innovationcentralph/HeatIndex/Firmware/HeatIndex_ModbusRelay/ModbusRegisters.md

# Modbus Register Documentation

This file documents the Modbus registers used in the project. Each register has an address, type, default value, and a brief description.

## Register Table

| Address | Type  | Default Value | Description | Range | Unit | Data Type |
|---|---|---|---|---|---|---|
| 1 | COIL  | 0 | Relay 1 | | - | uint16_t |
| 2 | COIL  | 0 | Relay 2 | | - | uint16_t |
| 3 | COIL  | 0 | Relay 3 | | - | uint16_t |
| 4 | COIL  | 0 | Relay 4 | | - | uint16_t |
