innovationcentralph/HeatIndex/HeatIndex/1_2350513_2/c-1-2350513-2-1-3d.stp

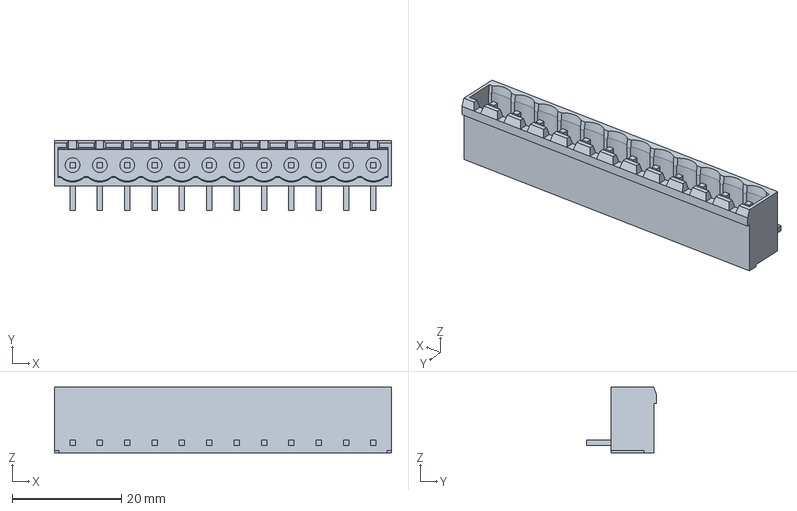
[picture p3: CAD file, 2025-08-19]
HeatIndex/1_2350513_2/c-1-2350513-2-1-3d.stp
61.6 x 12.8 x 12.0 mm
