innovationcentralph/HeatIndex/HeatIndex/APC_817B1_SL/APC-817xx-SL_AMB.step

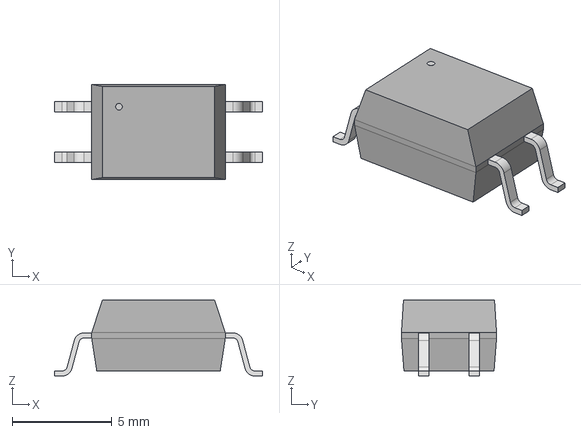
[picture p4: CAD file, 2025-08-19]
HeatIndex/APC_817B1_SL/APC-817xx-SL_AMB.step
10.4 x 4.78 x 3.81 mm
