innovationcentralph/HeatIndex/HeatIndex/B0505S_2WR3/B_S-2WR2_MNS.step

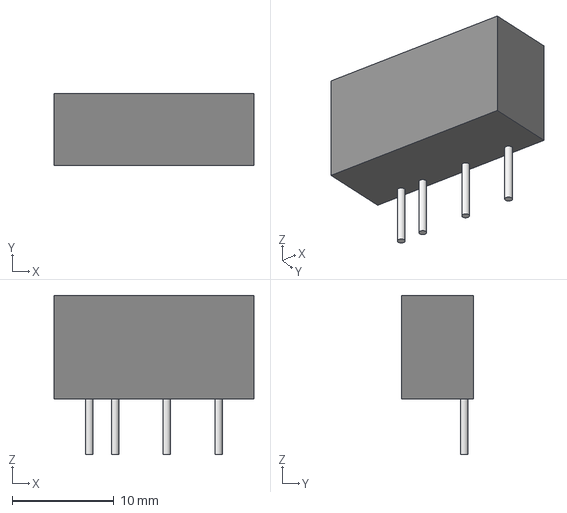
[picture p5: CAD file, 2025-08-19]
HeatIndex/B0505S_2WR3/B_S-2WR2_MNS.step
19.7 x 7.06 x 15.6 mm
