innovationcentralph/HeatIndex/HeatIndex/PC817X2NIP1B_SHP.step

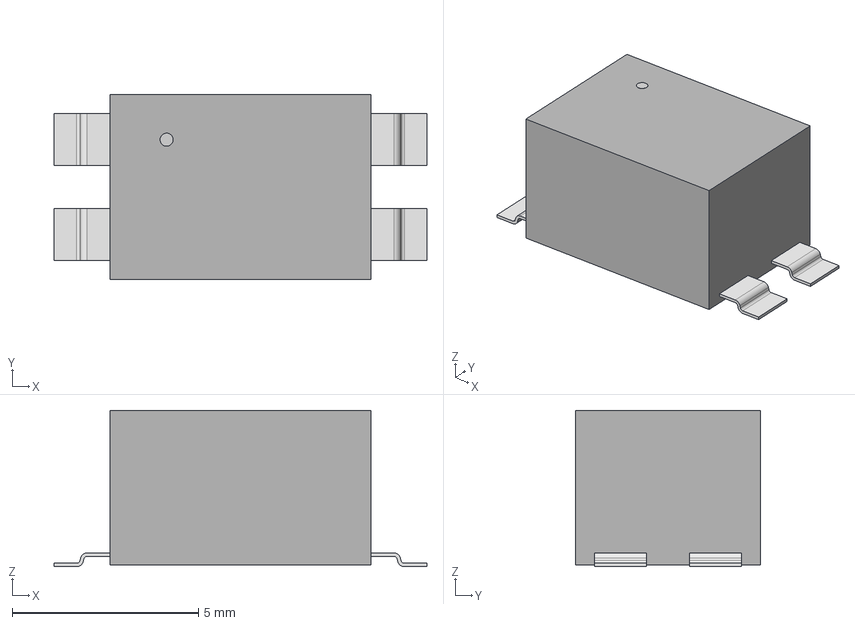
[picture p6: CAD file, 2025-08-19]
HeatIndex/PC817X2NIP1B_SHP.step
10.0 x 4.95 x 4.19 mm
