innovationcentralph/HeatIndex/(list of files, cad)

Other CAD files:
HeatIndex/B_S-2WR2_MNS.step
