innovationcentralph/HeatIndex/HeatIndex/HeatIndex.kicad_pcb

## KiCad design HeatIndex/HeatIndex.kicad_pcb (2025-09-29)

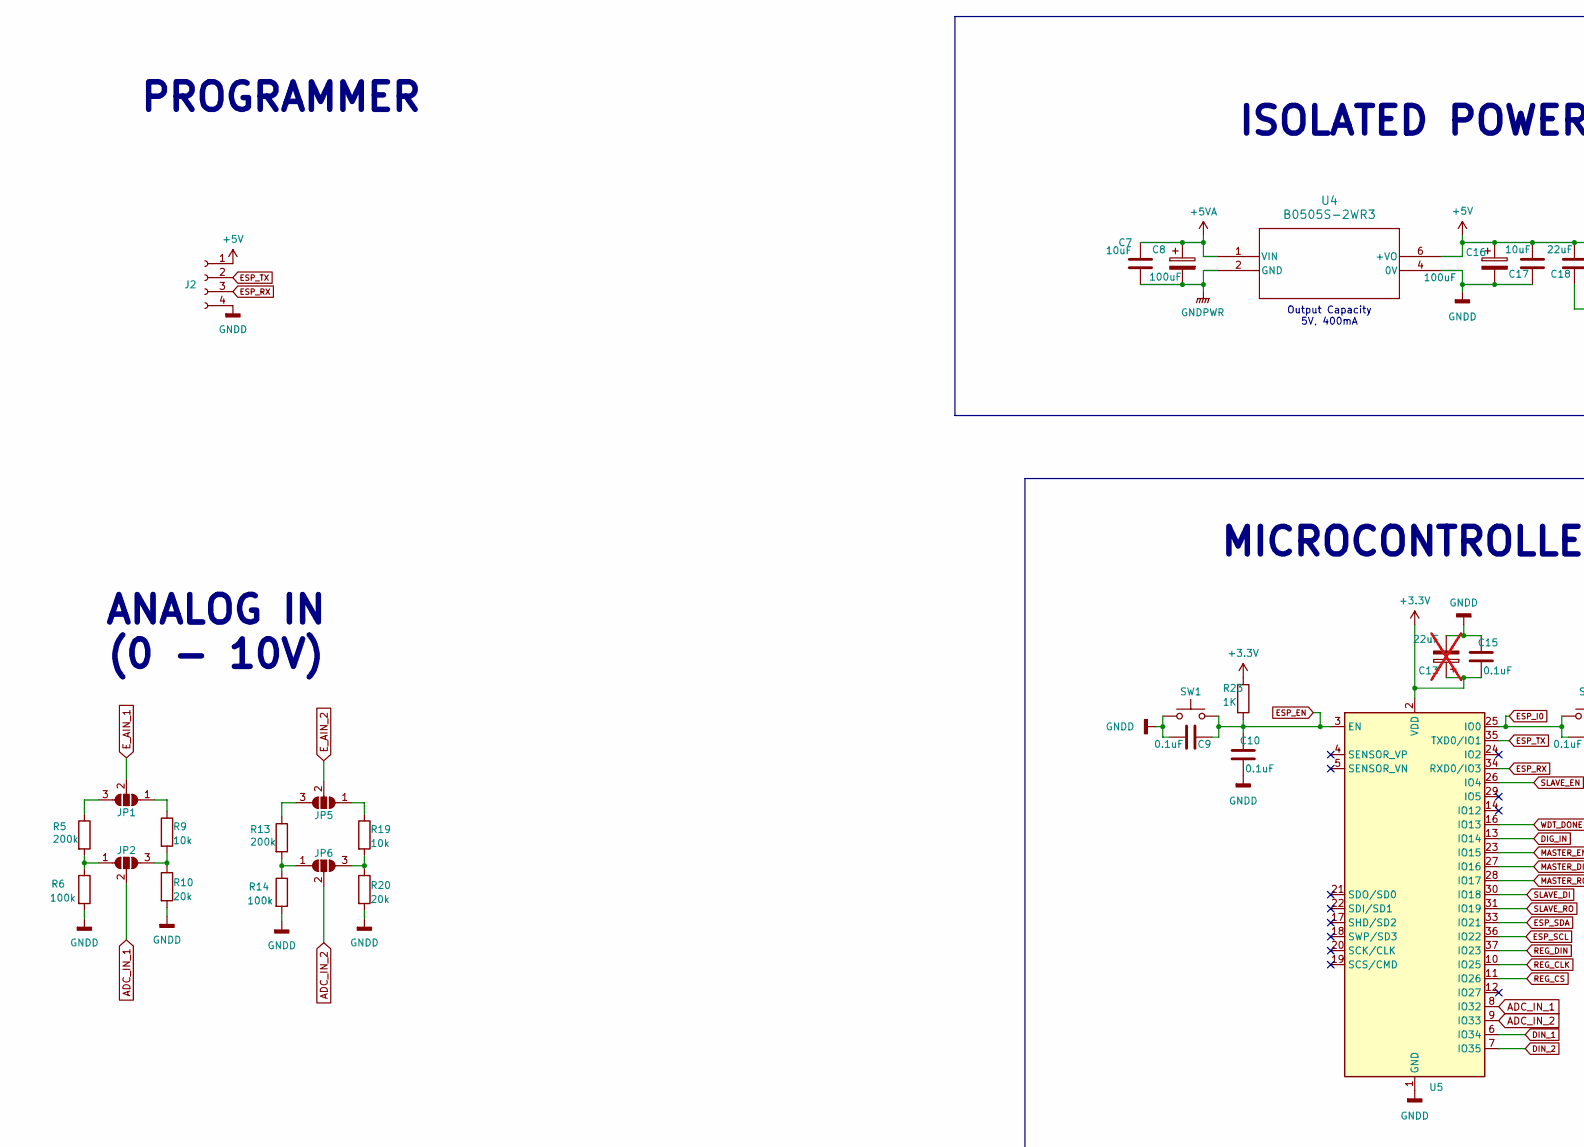
[picture p7: schematic HeatIndex.kicad_sch, part in row 1, column 1]

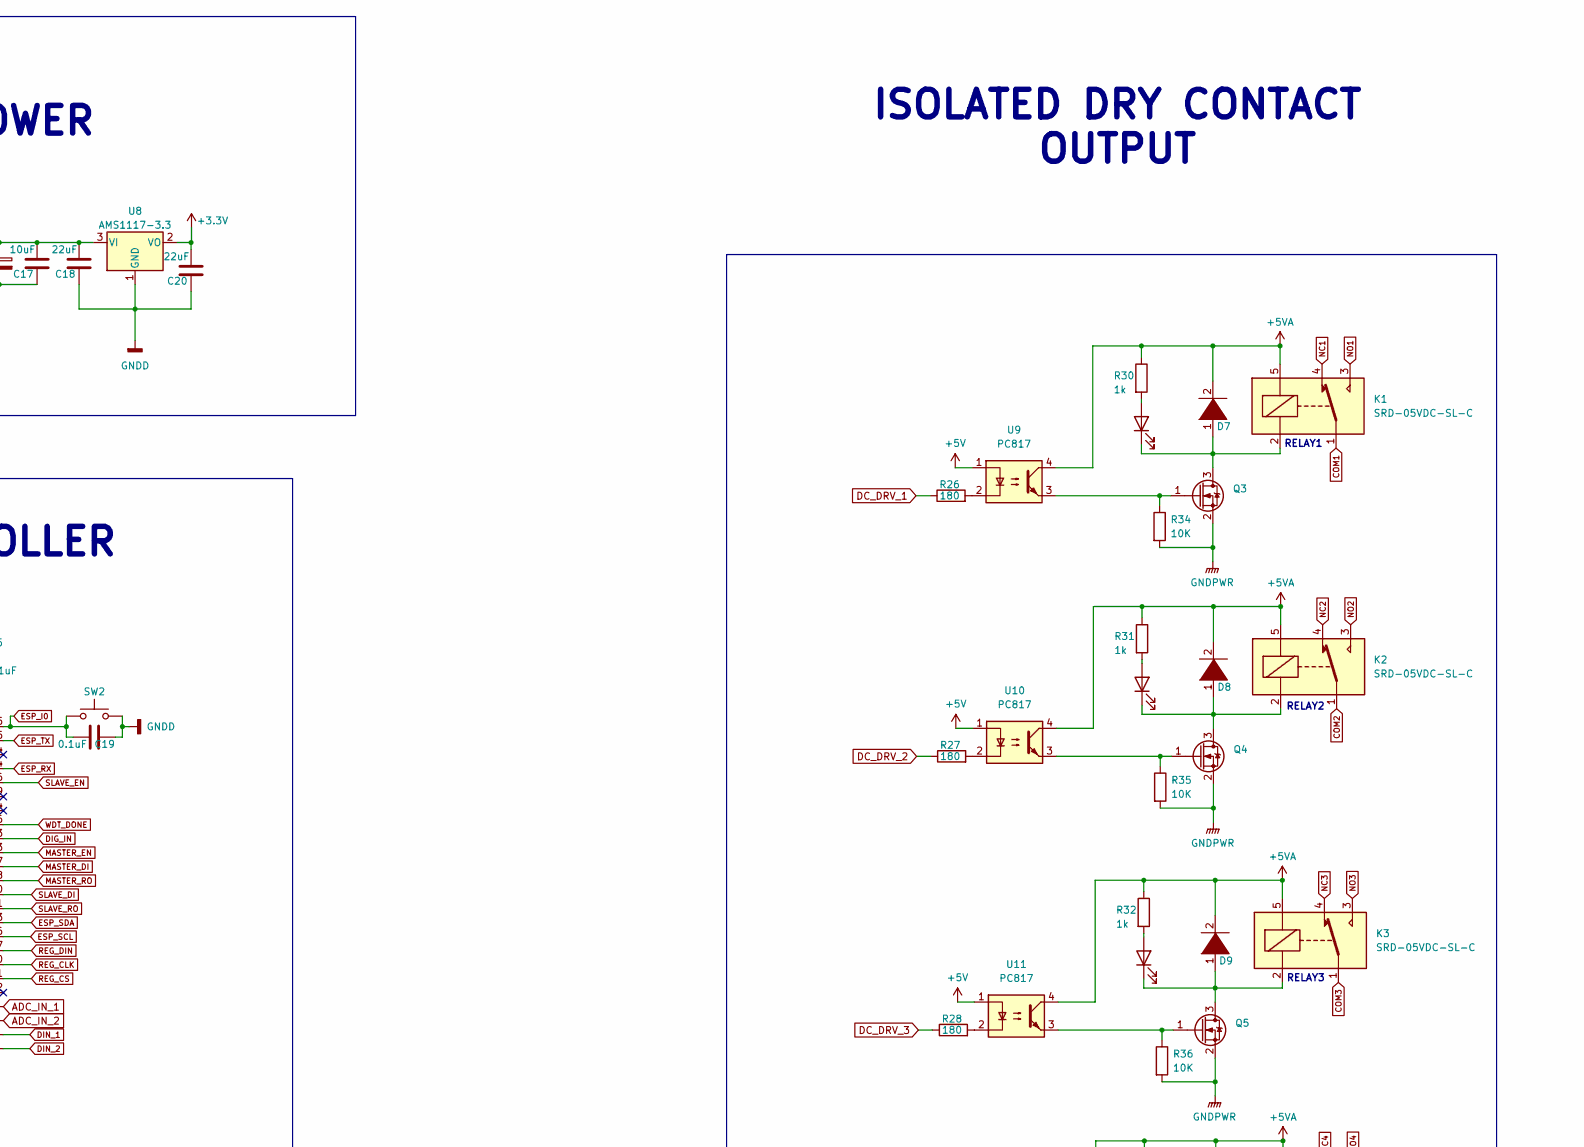
[picture p8: schematic HeatIndex.kicad_sch, part in row 1, column 2]

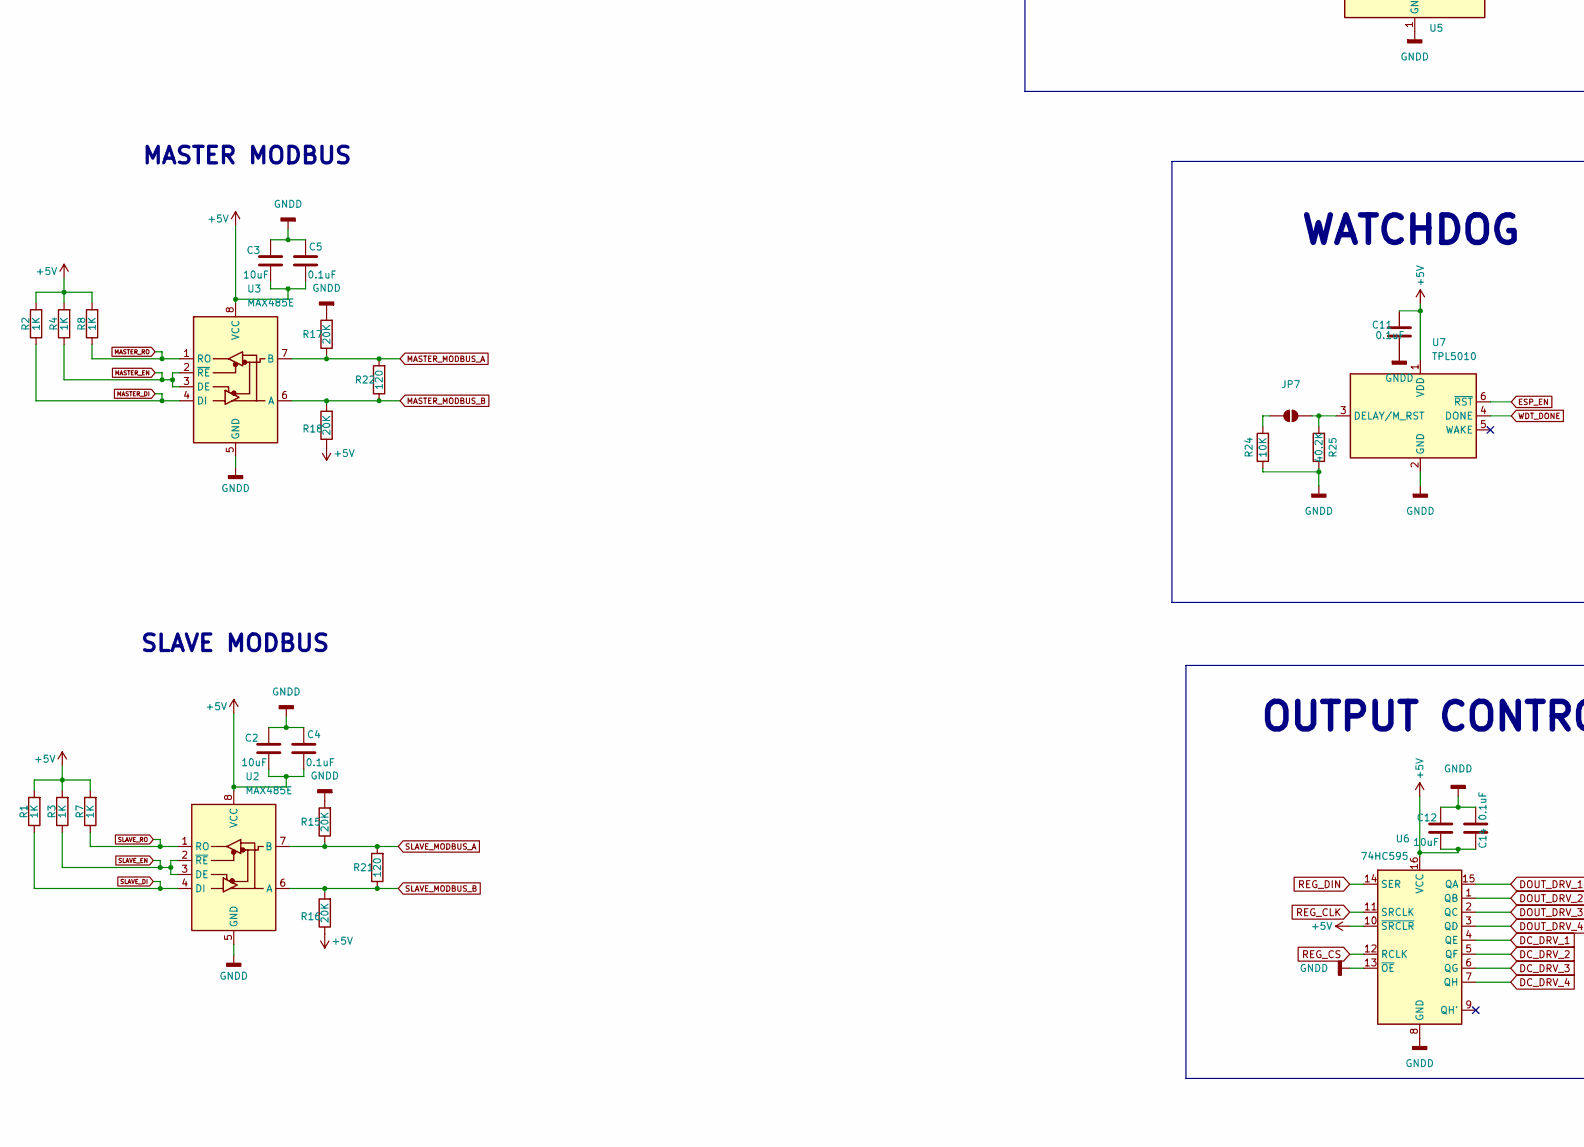
[picture p9: schematic HeatIndex.kicad_sch, part in row 2, column 1]

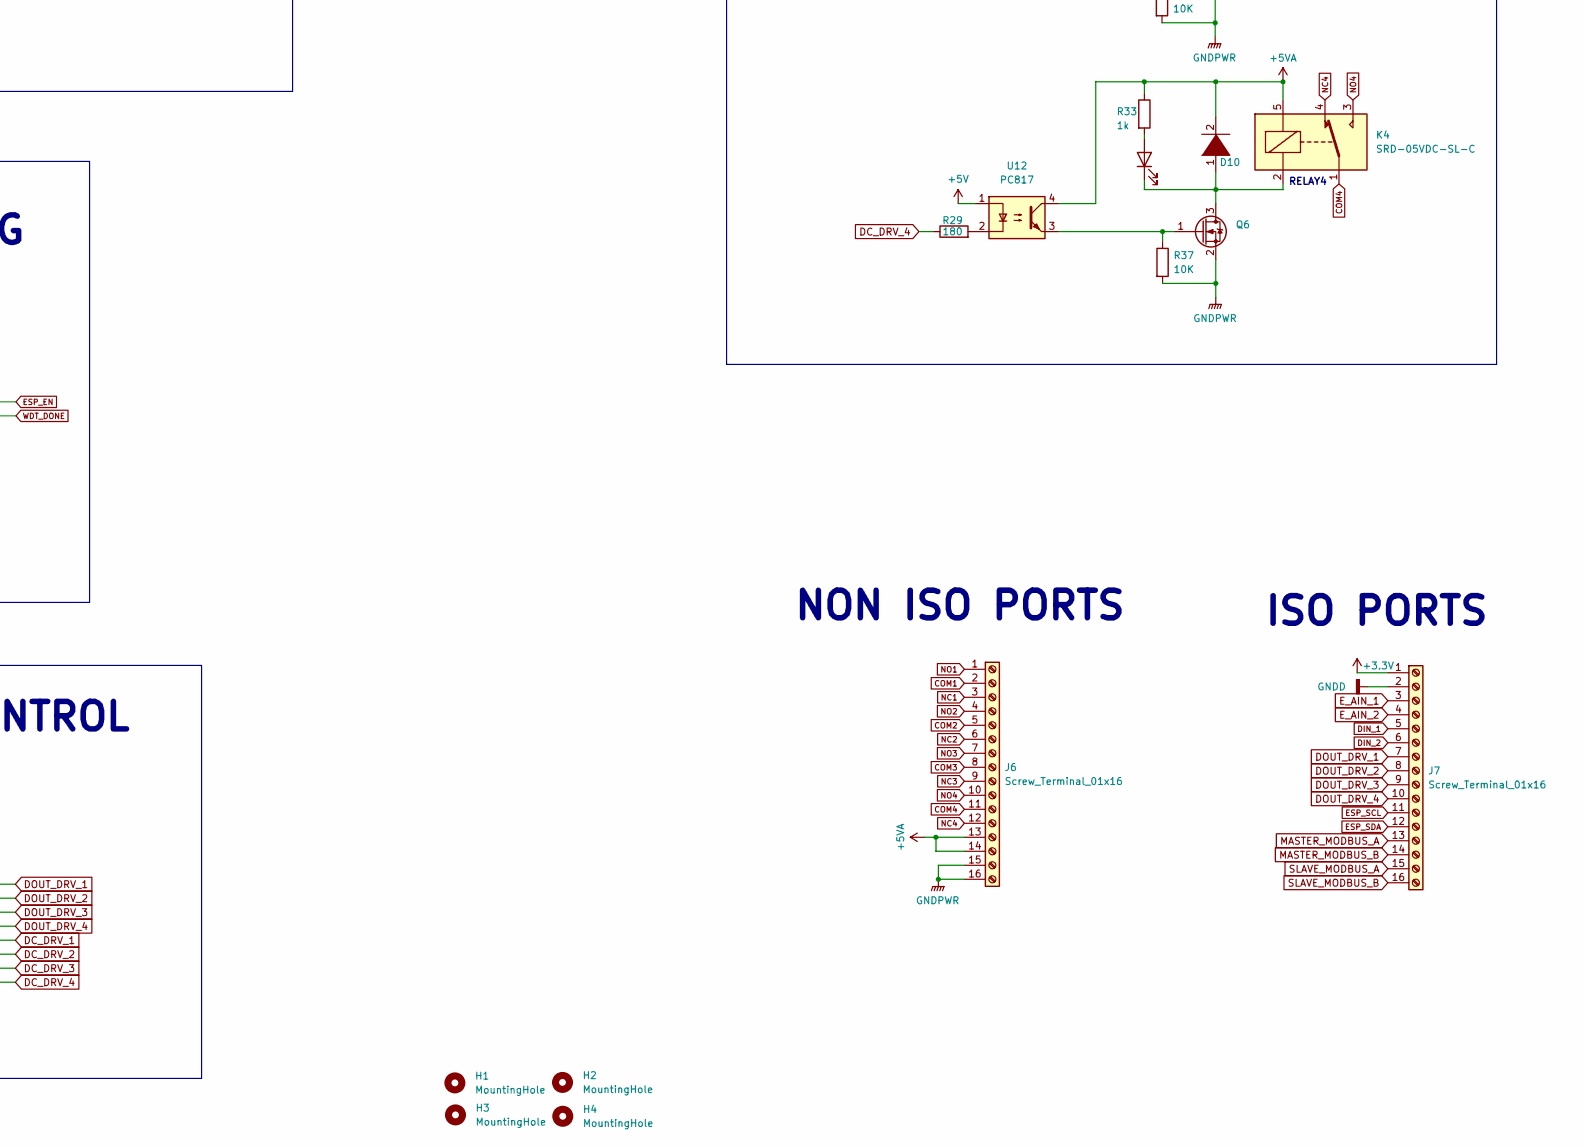
[picture p10: schematic HeatIndex.kicad_sch, part in row 2, column 2]

Parts:
C2, C3, C7, C12, C17: 10uF; C_0805_2012Metric_Pad1.18x1.45mm_HandSolder; LCSC C15850
C4, C5, C9, C10, C11, C14, C15, C19: 0.1uF; C_0603_1608Metric; LCSC C80516
C8, C16: 100uF; C_1210_3225Metric_Pad1.33x2.70mm_HandSolder; LCSC C394395
C13: 22uF; C_0603_1608Metric; LCSC C59461; not fitted
C18, C20: 22uF; C_0603_1608Metric; LCSC C59461
D3, D4, D5, D6: LED; LED_0805_2012Metric_Pad1.15x1.40mm_HandSolder; LCSC C2297
D7, D8, D9, D10: 1N4001; D_SOD-123F; LCSC C2892326
H1, H2, H3, H4: MountingHole; MountingHole_3.2mm_M3_DIN965_Pad_TopBottom
J2: Conn_01x04_Socket; JST_EH_B4B-EH-A_1x04_P2.50mm_Vertical
J6, J7: Screw_Terminal_01x16; TerminalBlock_Phoenix_MKDS-1,5-16-5.08_1x16_P5.08mm_Horizon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
JP1, JP2, JP5, JP6: SolderJumper_3_Open; SolderJumper-3_P1.3mm_Open_Pad1.0x1.5mm
JP7: SolderJumper_2_Open; SolderJumper-2_P1.3mm_Open_Pad1.0x1.5mm
K1, K2, K3, K4: SRD-05VDC-SL-C; Relay_SPDT_SANYOU_SRD_Series_Form_C; LCSC C35449
Q3, Q4, Q5, Q6: Q_NMOS_Depletion_GSD; SOT-23-3; LCSC C75882
R1, R2, R3, R4, R7, R8, R23: 1K; R_0603_1608Metric_Pad0.98x0.95mm_HandSolder; LCSC C21190
R5, R13: 200k; R_0603_1608Metric_Pad0.98x0.95mm_HandSolder; LCSC C95331
R6, R14: 100k; R_0603_1608Metric_Pad0.98x0.95mm_HandSolder; LCSC C14675
R9, R19: 10k; R_0603_1608Metric_Pad0.98x0.95mm_HandSolder; LCSC C25804
R10, R20: 20k; R_0603_1608Metric_Pad0.98x0.95mm_HandSolder; LCSC C2907011
R15, R16, R17, R18: 20K; R_0805_2012Metric_Pad1.20x1.40mm_HandSolder; LCSC C4328
R21, R22: 120; R_0805_2012Metric_Pad1.20x1.40mm_HandSolder; LCSC C114245
R24, R34, R35, R36, R37: 10K; R_0603_1608Metric_Pad0.98x0.95mm_HandSolder; LCSC C25804
R25: 40.2K; R_0603_1608Metric_Pad0.98x0.95mm_HandSolder; LCSC C12447
R26, R27, R28, R29: 180; R_0603_1608Metric_Pad0.98x0.95mm_HandSolder; LCSC C25210
R30, R31, R32, R33: 1k; R_0603_1608Metric_Pad0.98x0.95mm_HandSolder; LCSC C21190
SW1, SW2: SW_Push; SW_SPST_CK_RS282G05A3; LCSC C2689642
U2, U3: MAX485E; SOP-8_3.9x4.9mm_P1.27mm; LCSC C481667
U4: B0505S-2WR3; B_S-2WR2_MNS; LCSC C5369473
U5: ESP32-WROOM-32; LCSC C529577
U6: 74HC595; SOIC-16_3.9x9.9mm_P1.27mm; LCSC C5947
U7: TPL5010; SOT-23-6; LCSC C473912
U8: AMS1117-3.3; SOT-223-3_TabPin2; LCSC C6186
U9, U10, U11, U12: PC817; APC-817xx-SL_AMB; LCSC C66405

Connections:
+3.3V: C13.1, C15.1, C20.2, J7.1, R23.1, U5.2 (VDD), U8.2 (VO)
+5V: C2.2, C3.2, C4.1, C5.1, C11.1, C12.2, C14.2, C16.1, C17.2, C18.2, J2.1, R1.2, R2.2, R3.2, R4.2, R7.2, R8.2, R16.1, R18.1, U2.8 (VCC), U3.8 (VCC), U4.6 (+VO), U6.10 (~SRCLR), U6.16 (VCC), U7.1 (VDD), U8.3 (VI), U9.1, U10.1, U11.1, U12.1
+5VA: C7.2, C8.1, D7.2 (A), D8.2 (A), D9.2 (A), D10.2 (A), J6.13, J6.14, K1.5, K2.5, K3.5, K4.5, R30.1, R31.1, R32.1, R33.1, U4.1 (VIN), U9.4, U10.4, U11.4, U12.4
ADC_IN_1: JP2.2 (C), U5.8 (IO32)
ADC_IN_2: JP6.2 (C), U5.9 (IO33)
COM1: J6.2, K1.1
COM2: J6.5, K2.1
COM3: J6.8, K3.1
COM4: J6.11, K4.1
DC_DRV_1: R26.1, U6.4 (QE)
DC_DRV_2: R27.1, U6.5 (QF)
DC_DRV_3: R28.1, U6.6 (QG)
DC_DRV_4: R29.1, U6.7 (QH)
DIG_IN: U5.13 (IO14)
DIN_1: J7.5, U5.6 (IO34)
DIN_2: J7.6, U5.7 (IO35)
DOUT_DRV_1: J7.7, U6.15 (QA)
DOUT_DRV_2: J7.8, U6.1 (QB)
DOUT_DRV_3: J7.9, U6.2 (QC)
DOUT_DRV_4: J7.10, U6.3 (QD)
ESP_EN: C9.2, C10.2, R23.2, SW1.2, U5.3 (EN), U7.6 (~RST)
ESP_I0: C19.1, SW2.1, U5.25 (IO0)
ESP_RX: J2.3, U5.34 (RXD0/IO3)
ESP_SCL: J7.11, U5.36 (IO22)
ESP_SDA: J7.12, U5.33 (IO21)
ESP_TX: J2.2, U5.35 (TXD0/IO1)
E_AIN_1: J7.3, JP1.2 (C)
E_AIN_2: J7.4, JP5.2 (C)
GNDD: C2.1, C3.1, C4.2, C5.2, C9.1, C10.1, C11.2, C12.1, C13.2, C14.1, C15.2, C16.2, C17.1, C18.1, C19.2, C20.1, J2.4, J7.2, R6.2, R10.2, R14.2, R15.2, R17.2, R20.2, R24.1, R25.1, SW1.1, SW2.2, U2.5 (GND), U3.5 (GND), U4.4 (0V), U5.1 (GND), U5.15 (GND), U5.38 (GND), U5.39 (GND), U6.8 (GND), U6.13 (~OE), U7.2 (GND), U8.1 (GND)
GNDPWR: C7.1, C8.2, J6.15, J6.16, Q3.2 (S), Q4.2 (S), Q5.2 (S), Q6.2 (S), R34.2, R35.2, R36.2, R37.2, U4.2 (GND)
MASTER_DI: R2.1, U3.4 (DI), U5.27 (IO16)
MASTER_EN: R4.1, U3.2 (~RE), U3.3 (DE), U5.23 (IO15)
MASTER_MODBUS_A: J7.13, R17.1, R22.2, U3.7 (B)
MASTER_MODBUS_B: J7.14, R18.2, R22.1, U3.6 (A)
MASTER_RO: R8.1, U3.1 (RO), U5.28 (IO17)
NC1: J6.3, K1.4
NC2: J6.6, K2.4
NC3: J6.9, K3.4
NC4: J6.12, K4.4
NO1: J6.1, K1.3
NO2: J6.4, K2.3
NO3: J6.7, K3.3
NO4: J6.10, K4.3
unnamed: D3.2 (A), R30.2
unnamed: D3.1 (K), D7.1 (K), K1.2, Q3.3 (D)
unnamed: D4.2 (A), R31.2
unnamed: D4.1 (K), D8.1 (K), K2.2, Q4.3 (D)
unnamed: D5.2 (A), R32.2
unnamed: D5.1 (K), D9.1 (K), K3.2, Q5.3 (D)
unnamed: D6.2 (A), R33.2
unnamed: D6.1 (K), D10.1 (K), K4.2, Q6.3 (D)
unnamed: JP1.1 (A), R9.1
unnamed: JP1.3 (B), R5.1
unnamed: JP2.1 (A), R5.2, R6.1
unnamed: JP2.3 (B), R9.2, R10.1
unnamed: JP5.1 (A), R19.1
unnamed: JP5.3 (B), R13.1
unnamed: JP6.1 (A), R13.2, R14.1
unnamed: JP6.3 (B), R19.2, R20.1
unnamed: JP7.1 (A), R24.2
unnamed: JP7.2 (B), R25.2, U7.3 (DELAY/M_RST)
unnamed: Q3.1 (G), R34.1, U9.3
unnamed: Q4.1 (G), R35.1, U10.3
unnamed: Q5.1 (G), R36.1, U11.3
unnamed: Q6.1 (G), R37.1, U12.3
unnamed: R26.2, U9.2
unnamed: R27.2, U10.2
unnamed: R28.2, U11.2
unnamed: R29.2, U12.2
REG_CLK: U5.10 (IO25), U6.11 (SRCLK)
REG_CS: U5.11 (IO26), U6.12 (RCLK)
REG_DIN: U5.37 (IO23), U6.14 (SER)
SLAVE_DI: R1.1, U2.4 (DI), U5.30 (IO18)
SLAVE_EN: R3.1, U2.2 (~RE), U2.3 (DE), U5.26 (IO4)
SLAVE_MODBUS_A: J7.15, R15.1, R21.2, U2.7 (B)
SLAVE_MODBUS_B: J7.16, R16.2, R21.1, U2.6 (A)
SLAVE_RO: R7.1, U2.1 (RO), U5.31 (IO19)
WDT_DONE: U5.16 (IO13), U7.4 (DONE)

Notes on the sheet:
RELAY1
Output Capacity 5V, 400mA
WATCHDOG
RELAY4
ISOLATED DRY CONTACT OUTPUT
MASTER MODBUS
SLAVE MODBUS
ISOLATED POWER
RELAY3
PROGRAMMER
ISO PORTS
MICROCONTROLLER
NON ISO PORTS
ANALOG IN (0 - 10V)
OUTPUT CONTROL
RELAY2

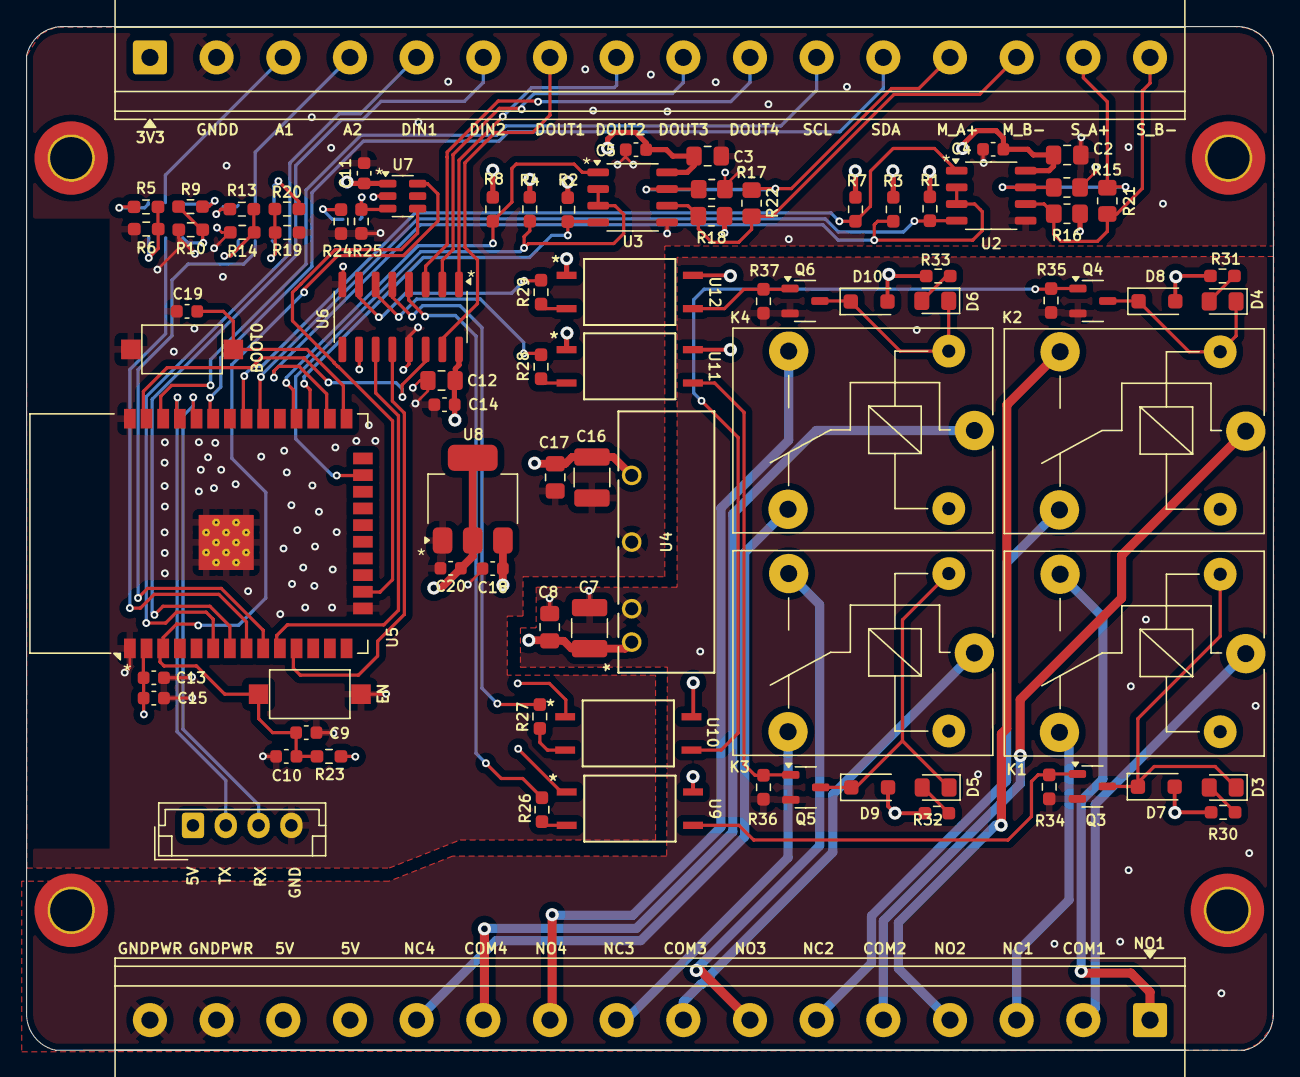
[picture p11: board HeatIndex.kicad_pcb from above]

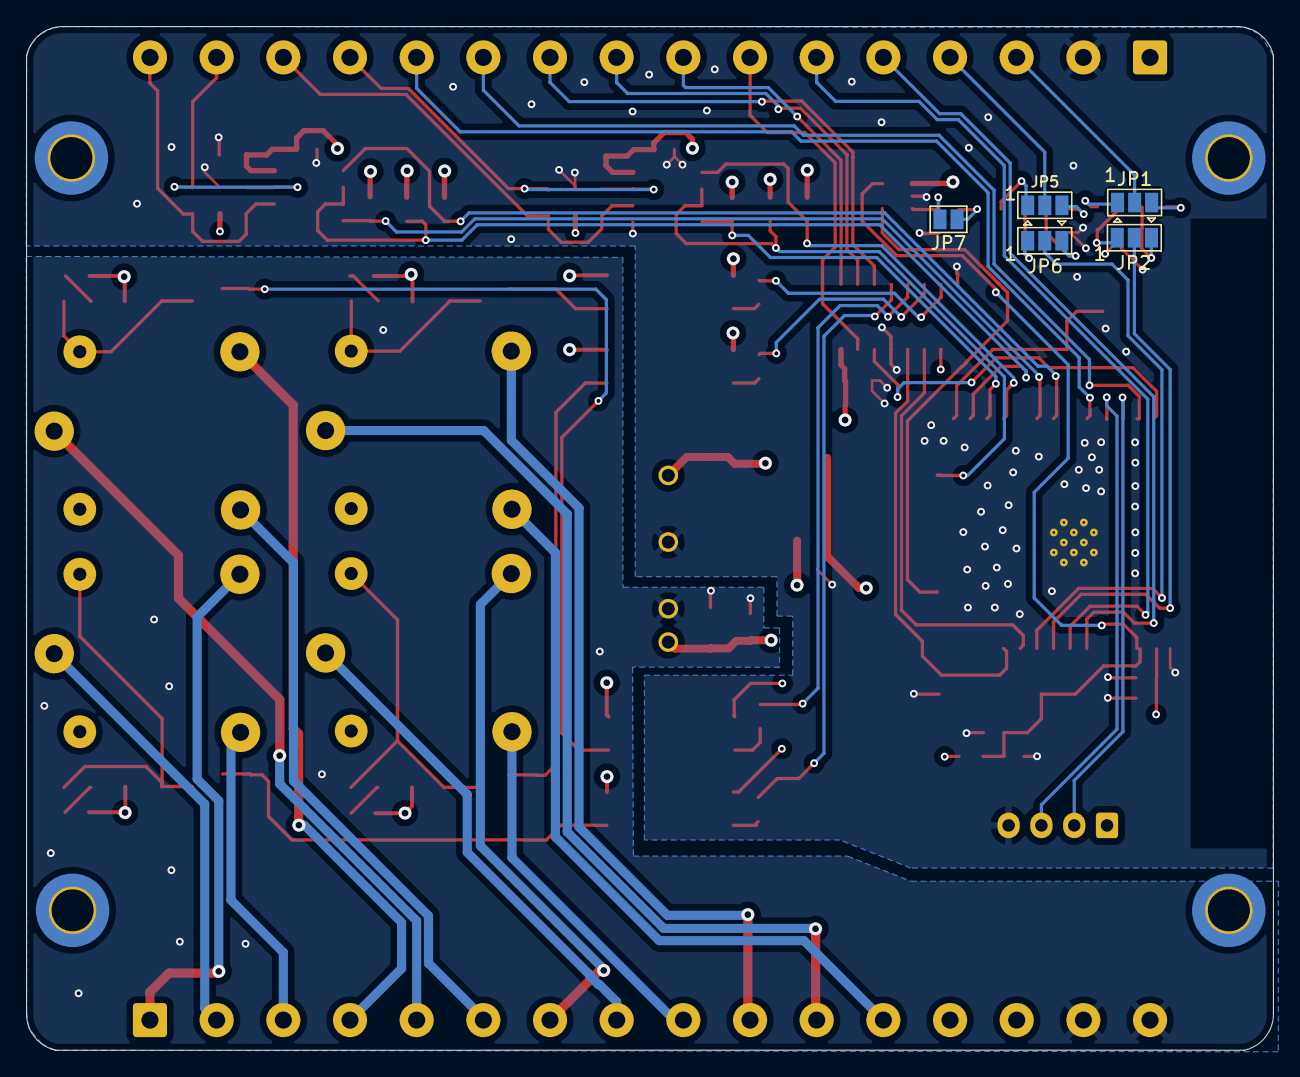
[picture p12: board HeatIndex.kicad_pcb from below]

Board: 4 copper layers, 95.0 x 78.0 mm, 94 parts (5 on the bottom side), 77 nets.
