innovationcentralph/HeatIndex/Firmware/HeatIndex_ModbusRelay/PinConfig.h

#ifndef PIN_CONFIG_H
#define PIN_CONFIG_H

// RS485 Pin Definitions
#define TX_PIN 18              // TX GPIO pin for RS485
#define RX_PIN 19              // RX GPIO pin for RS485
#define TXRX_CONTROL_PIN 4     // TX/RX control pin for RS485 transceiver

#define OUT_CTRL_DIN     23
#define OUT_CTRL_CLK     25
#define OUT_CTRL_CS      26

#define BIT_OFF 1
#define BIT_ON  0

#endif // PIN_CONFIG_H
