innovationcentralph/HeatIndex/(commit log)

2025-08-19 -heat index lcsc checking
    [APC-817xx-SL_AMB.step, B_S-2WR2_MNS.step, HeatIndex.csv, HeatIndex.kicad_pcb, HeatIndex.kicad_sch, PC817X2NIP1B_SHP.step, c-1-2350513-2-1-3d.stp]
2025-09-29 -push firmware
    [HeatIndex.kicad_pcb, HeatIndex.kicad_sch]
